denishelenko/esp8266-motor-control/docs/wiring-two-variants.png

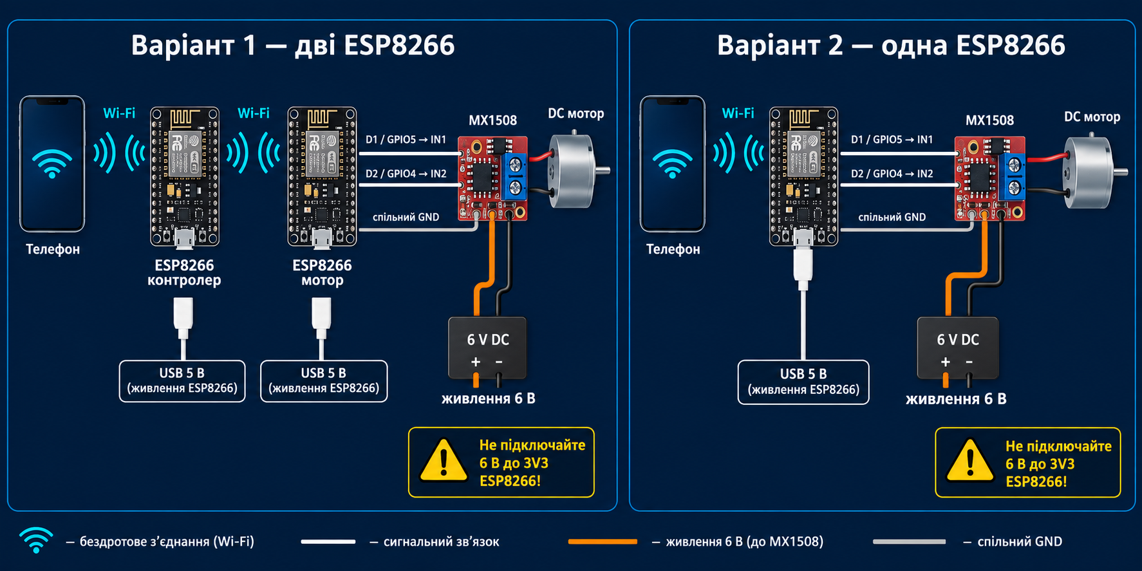
docs/wiring-two-variants.png
