denishelenko/esp8266-motor-control/12GAN20-20/Home dev internet/2_Carriages_WebSite/README.md

# Дві ESP32-S3 у мережі Motor-Control

Це окрема Home-версія двох кареток. Обидві плати ESP32-S3 N16R8 підключаються до **наявної** точки доступу `Motor-Control`, пароль `motor8266`. Мережу має створювати інший пристрій або роутер. Якщо точку доступу створювала стара ESP, вона повинна залишатися увімкненою. Жодна з цих двох кареток не роздає Wi-Fi.

**Обов'язково зафіксуйте на точці доступу 2,4 ГГц і канал 6.** Для ESP-NOW і Wi-Fi станції на одному радіомодулі потрібен спільний канал. Якщо точка доступу сама змінить канал, ці прошивки відхилять підключення до неї. Коли зовнішньої мережі немає, каретки залишаються на каналі 6 і можуть продовжувати обмін ESP-NOW, але сайт і OTA недоступні. Повторна спроба підключення робиться раз на 30 с тільки коли мотори стоять. Під час такої спроби команди руху тимчасово блокуються, оскільки один радіомодуль не гарантує безперервну передачу ESP-NOW під час сканування Wi-Fi.

| Роль | Arduino IDE | PlatformIO USB | PlatformIO OTA | Мережева адреса |
| --- | --- | --- | --- | --- |
| Головна каретка та сайт | `ESP32S3_Controller_Carriage_1/ESP32S3_Controller_Carriage_1.ino` | `dual_home_main_serial` | `dual_home_main_ota` | `http://motor.local/` |
| Друга каретка | `ESP32S3_Carriage_2/ESP32S3_Carriage_2.ino` | `dual_home_remote_serial` | `dual_home_remote_ota` | `motor-carriage-2.local` тільки для OTA |

Перший раз прошийте **кожну** плату через USB. В Arduino IDE виберіть 16 MB flash і **Partition Scheme: Custom**: у кожному скетчі вже є свій `partitions.csv` із двома OTA слотами. PlatformIO використовує таку саму таблицю розділів `default_16MB.csv`. Після цього підключіть комп'ютер до тієї самої мережі й прошивайте відповідним OTA профілем. OTA використовує порт 3232 і пароль `motor8266`. Якщо `.local` не знаходиться, використайте IP із Serial Monitor як `upload_port` у відповідному профілі.

Ніякого автоматичного визначення «застарілої прошивки» чи автоматичного завантаження немає. Оновлення починається лише після вашої команди **Upload**. Поки OTA не почався, ESP-NOW продовжує передавати команди та підтвердження. З початком OTA відповідна каретка зупиняє виходи й не виконує команди. Якщо оновлюється головна каретка, друга зупиниться за стоп-командою або власним тайм-аутом до 700 мс. Послідовне оновлення плат зменшує час, коли одна з них недоступна.

Для обох Home-кареток використовуйте [спільну схему підключення](../../README_TWO_CARRIAGES.md#піни-на-обох-каретках). Драйвер підключається до GPIO1 і GPIO2, сигнал на A1 TXS0108E до GPIO42, червоний LED до GPIO47, зелений до GPIO21. Фізичну перевірку зв'язку, руху та OTA на платах ще потрібно провести.
