denishelenko/esp8266-motor-control/12GAN20-20/2_Carriages_WebSite/ESP32S3_Carriage_2/README.md

# ESP32-S3 — друга каретка

Відкрийте `ESP32S3_Carriage_2.ino` в Arduino IDE.

Налаштування Arduino IDE такі самі, як для головної плати: `ESP32S3 Dev Module`, 16 MB Flash, OPI PSRAM, Upload Speed 115200.

Плата не створює власний сайт. Вона підключається до Wi‑Fi `Motor-Control` головної ESP32-S3 та приймає UDP-команди.
