denishelenko/esp8266-motor-control/12GAN20-20/Home dev internet/NodeMCU/README.md

# NodeMCU: однокареткова прошивка для домашнього Wi‑Fi

Це готова окрема копія скетчу для NodeMCU v3. Усі файли для Arduino IDE знаходяться в цій папці.

1. Відкрийте `NodeMCU.ino` саме з цієї папки.
2. В Arduino IDE виберіть `NodeMCU 1.0 (ESP-12E Module)`.
3. Виберіть правильний COM-порт і прошийте плату.
4. Відкрийте Serial Monitor на швидкості `115200`.

Назву мережі та пароль введіть безпосередньо у верхній частині `config.h`:

```cpp
constexpr char HOME_WIFI_SSID[] = "ENTER_WIFI_NAME";
constexpr char HOME_WIFI_PASSWORD[] = "ENTER_WIFI_PASSWORD";
```

У локальній копії для поточного тесту вже введено значення мережі. Перед публікацією замініть їх на заглушки.

Після запуску NodeMCU підключається тільки до домашнього Wi‑Fi, без створення мережі `Motor-Control`. У Serial Monitor з’явиться IP-адреса. Телефон потрібно підключити до тієї самої домашньої мережі, а сайт відкрити за цією IP-адресою.

Підключення каретки, двигунів, сервоприводу та RGB-індикатора не змінюється:

```text
D1 → IN1 L298N (PWM)
D2 → IN2 L298N (PWM)
D5 → сигнал сервоприводу через TXS0108E
D0 → R RGB (червоний)
D7 → G RGB (зелений)
```

Перемичку ENA на L298N залиште встановленою. Окремий ENA GPIO не використовується: PWM подається на активний IN1 або IN2.
