denishelenko/esp8266-motor-control/README_TWO_CARRIAGES.md

# Дві каретки: ESP32 + NodeMCU

Ця версія знаходиться на гілці `two-carriages` і не змінює `main`.

Детальна безпечна послідовність живлення та пайки: [`docs/WIRING_TWO_CARRIAGES.md`](docs/WIRING_TWO_CARRIAGES.md).

## Що прошивати

1. `ArduinoIDE/12_TwoCarriages_ESP32_Controller/` — ESP32-S3, перша каретка та сайт.
2. `ArduinoIDE/13_TwoCarriages_NodeMCU/` — NodeMCU v3, друга каретка.

Прошийте **обидві** плати з цієї версії: UDP-протокол версії 3 додає ідентифікатор сеансу та підтвердження команди. Старі прошивки з ним несумісні.

Телефон підключається лише до Wi-Fi ESP32:

- мережа: `Motor-Control`
- пароль: `motor8266`
- основна адреса сайту: `http://motor-control.local/`
- резервна адреса сайту: `http://192.168.4.1/`

Після підключення до Wi-Fi достатньо оновити сторінку за адресою `http://motor-control.local/`. Ім'я оголошує ESP32 через mDNS; NodeMCU адресу сайту не створює, а лише підключається до мережі ESP32.

NodeMCU автоматично підключається до цієї ж мережі і надсилає ESP32 свій статус. MAC-адреси та IP другої каретки вручну вводити не потрібно: ESP32 запам'ятовує адресу пакета статусу.

## Піни

### Перша каретка, ESP32-S3 + L298N

- GPIO4 → ENA, без перемички ENA.
- GPIO5 → IN1.
- GPIO6 → IN2.
- GPIO15 → жовтий сигнальний провід сервоприводу каретки 1.
- Спільний GND ESP32, L298N і джерела живлення обов'язковий.

### Друга каретка, NodeMCU v3 + L298N

- D1 / GPIO5 → ENA, без перемички ENA.
- D2 / GPIO4 → IN1.
- D5 / GPIO14 → IN2.
- D6 / GPIO12 → жовтий сигнальний провід сервоприводу каретки 2.
- GND NodeMCU → GND L298N.

Червоний провід кожного сервоприводу підключіть до окремого стабілізованого джерела 5–8.4 V, коричневий — до його GND. GND цього джерела, контролера і драйвера мають бути спільні. Не живіть сервоприводи від 3.3 V плати; вихід 5 V L298N також не варто використовувати без перевірки його струмової спроможності. Живлення двигуна — окремо відповідно до вашого L298N та двигуна.

## Як це працює

- ESP32 створює Wi-Fi AP і тримає сайт з WebSocket: усі телефони бачать спільний стан.
- ESP32 керує мотором каретки 1 напряму.
- ESP32 надсилає UDP-команду каретці 2 кожні 50 мс. NodeMCU одразу підтверджує номер прийнятої команди та передає фактично поданий PWM і стан сервоприводу; крім цього, статус надсилається кожні 300 мс.
- Сайт показує NodeMCU «онлайн» лише за свіжим статусом **і** новим підтвердженням команди (до 500 мс). Коли підтвердження зникає, друга каретка позначається «офлайн / немає сигналу», ланцюжок перекреслюється, її програма зупиняється; у режимі з'єднаного ланцюжка зупиняється й перша. Стара програма після відновлення зв'язку не запускається автоматично.
- Поки статус NodeMCU надходить, але підтвердження команди ще немає, ESP32 повторно надсилає **лише нульовий PWM і закритий сервопривід**, щоб безпечно відновити обмін. NodeMCU сам повторно підключається до Wi-Fi після розриву. Це підтвердження приймання команди, а не датчик фактичного положення каретки.
- Без нових команд NodeMCU починає зменшувати PWM після 700 мс і закриває сервопривід; двигун зупиняється плавно, не миттєво. ESP32 також плавно змінює PWM та проходить через нуль перед зміною напрямку.
- Якщо вимкнути синхронізацію кнопкою ланцюжка, команди й програми стосуються тільки вибраної каретки.
- «Маятник» вибраний за замовчуванням, але не запускається сам. «Старт» запускає вибраний режим, «Стоп» зупиняє тільки рух: увімкнений сервопривід продовжує свій цикл. Повторний «Старт» не скидає фазу сервоприводу. Натискання іншого режиму одразу запускає його. Пересування мішені скасовує режим і закриває сервопривід; повторний «Старт» запускає збережений вибраний режим.
- «Вимк.» у блоці «Керування сервоприводом» вимикає тільки його, не зупиняючи програму руху. Натискання 45° або 90° вмикає сервопривід і під час програми, і після «Стоп». При втраті зв’язку з NodeMCU сервопривід другої каретки вимикається з міркувань безпеки.
- Для кожної каретки окремо вибирається 45° або 90° фізичного відкриття сервоприводу. Під час режиму подається команда закриття на 2 с, потім команда відкриття на 1 с, і цикл повторюється. За результатами попереднього тесту команди сервоприводу подвоюються: 90° команди дають близько 45° фізично, 180° — близько 90°. Це не вимірювання положення: сервопривід не дає зворотного зв'язку, тому фактичний час досягнення кута залежить від механіки.
- Демо `web-interface-two-carriages-demo.html` не керує залізом і показує умовні 2 поділки сигналу для першої каретки та 4 для другої. Додайте `?node=offline` до адреси демо, щоб побачити вигляд втрати другої каретки. У робочому сайті рівень другої каретки береться з Wi-Fi RSSI NodeMCU, а «онлайн» вимагає підтвердження команд; для першої поки показано умовні 4 поділки, бо вона сама створює Wi-Fi. RSSI сам по собі не гарантує швидкості чи надійності зв'язку.

## Робоча ділянка й ручне вимірювання часу

У `ArduinoIDE/12_TwoCarriages_ESP32_Controller/config.h` задано `TRACK_LENGTH_M = 20` та `SAFE_MARGIN_M = 2`: від фізичних країв залишається по 2 м, робочий відрізок становить 16 м, а на сайті видно координати від −8 до +8 м. Фізичний центр потрібно встановити вручну та натиснути «Позначити поточне місце як центр». Це скидає **розрахункову** координату, а не визначає справжнє положення датчиком.

Окремий скетч `ArduinoIDE/14_Travel_Time_Test/` можна тимчасово прошити в кожну плату по черзі. Він не запускає двигун після ввімкнення. У Serial Monitor на 115200 baud введіть `P50` для 50%, поставте каретку на ліву робочу позначку (2 м від фізичного кінця), `R` для руху вправо та `S`, коли вона досягне правої робочої позначки. Запишіть час. Повторіть із `L` у зворотному напрямку. Час відлічується між введенням команд; затримка реакції людини впливає на точність. Не допускайте упору двигуна в механічний стопор: скетч **не має датчика кінця**, а 120-секундний тайм-аут лише обмежує тривалість руху.

Впишіть чотири виміряні значення (вправо/вліво для кожної каретки) у `TRAVEL_TIMES` у конфігурації ESP32. `TRAVEL_CALIBRATION_SPEED_PERCENT = 50` має відповідати швидкості тесту. До внесення даних код використовує явно позначену **тимчасову, не виміряну** оцінку `UNCALIBRATED_SPEED_AT_100_PERCENT_MPS = 0.80`. На інших швидкостях час оцінюється пропорційно PWM — це лише грубе припущення; для точності потрібно виміряти кілька швидкостей або додати енкодер.

Інший окремий скетч `ArduinoIDE/15_Servo_Travel_Test/` перевіряє тільки сервопривід на відповідному сигнальному піні. У Serial Monitor на 115200 введіть `0`, `90` або `180` — це **командні** градуси сервоприводу; за вашим тестом вони відповідають приблизно 0°, 45° і 90° фізично. Надішліть `D`, коли він фактично дійде до кута, і запишіть приблизний час. Через реакцію людини краще зняти рух на відео та порівняти кадри. Після вимірювання змініть два значення `SERVO_TRAVEL_90_MS` для кареток 1/2 у конфігурації ESP32: це впливає лише на анімацію стрілки на сайті, не прискорює фізичний сервопривід.

Після тестів знову прошийте в плати основні скетчі `12_...` і `13_...`: тестові скетчі сайту не створюють.

Координата на мішені поки що розрахункова. Перед механічним запуском перевірте напрямок, низьку швидкість та кнопку «Стоп». Програмне обмеження без енкодера й кінцевиків не гарантує захисту від фізичного виходу за край троса; проскальзування колеса також накопичує помилку координати. Після втрати зв'язку, прослизання або ручного пересування каретки повторно встановіть її у фізичний центр і обнуліть координату перед запуском програми.
