denishelenko/esp8266-motor-control/12GAN20-20/README_TWO_CARRIAGES.md

# Дві каретки: ESP32-S3 + ESP32-S3

Для вимірювання фактичного руху на 1, 2 і 5 секунд дивіться [фізичне калібрування](CALIBRATION_TWO_ESP32.md).

Комплект використовує дві **ESP32-S3 DevKitC-1 N16R8 з антенами 2,4 ГГц**. Перша плата створює Wi‑Fi для телефона, тримає сайт і керує своєю кареткою. Друга виконує команди й повертає статус через ESP-NOW.

**Живлення:** MP1584 є понижувачем, тому з батареї 7,8–8,4 V він може зробити 5 V, але не 12 V. Не подавайте 12 V на драйвер лише за написом «L9110S»: [даташит HTCSEMI](https://datasheet.lcsc.com/lcsc/2109081930_HTCSEMI-L9110S_C2895059.pdf) допускає до 12 V та близько 800 мА безперервно на канал, тоді як [даташит UMW](https://www.laskakit.cz/user/related_files/l9110s.pdf) задає робочі 2,2–6,5 V та абсолютну межу 8 V. Потрібно встановити виробника мікросхем на вашому модулі, перевірити їхню межу живлення, розпіновку, допустимий пусковий струм кожного мотора та сумісність входів з логікою ESP32-S3 3,3 V. Якщо це не підтверджено, використайте драйвер із документованою підтримкою 12 V, 3,3 V логіки й потрібного струму.

## Що прошивати

1. [ESP32S3_Controller_Carriage_1.ino](<Arduino IDE/2_Carriages_WebSite/ESP32S3_Controller_Carriage_1/ESP32S3_Controller_Carriage_1.ino>) або профіль `dual_esp32s3_controller`.
2. [ESP32S3_Carriage_2.ino](<Arduino IDE/2_Carriages_WebSite/ESP32S3_Carriage_2/ESP32S3_Carriage_2.ino>) або профіль `dual_esp32s3_remote`.

Прошийте **обидві** плати з цієї пари. У PlatformIO відкрийте [папку проєкту](PlatformIO).

В Arduino IDE виберіть `ESP32S3 Dev Module`, Flash Size `16MB`, PSRAM `OPI PSRAM` і Upload Speed `115200`. Перевірені версії пакета `esp32 by Espressif Systems` 3.3.12, `ArduinoJson` 7.4.3 і `WebSockets` 2.7.2. Другий скетч використовує бібліотеки з пакета плат. Serial Monitor працює на `115200` бод.

Телефон підключається лише до Wi-Fi ESP32:

- мережа: `Motor-Control`
- пароль: `motor8266`
- основна адреса сайту: `http://motor-control.local/`
- резервна адреса сайту: `http://192.168.4.1/`

Після підключення до Wi-Fi достатньо оновити сторінку за адресою `http://motor-control.local/`. Ім'я оголошує головна ESP32-S3 через mDNS; друга ESP32-S3 сайту не створює, а обмінюється командами через ESP-NOW на тому самому радіоканалі.

Друга ESP32-S3 спілкується з головною через ESP-NOW; у звичайній версії вона не підключається як Wi-Fi-клієнт до мережі головної плати. Обидві використовують канал `WIFI_CHANNEL = 6` і той самий `ESPNOW_GROUP_ID` у своїх `config.h`. Плати запам'ятовують MAC-адреси автоматично. Якщо поруч працюватимуть кілька комплектів, задайте кожній парі свій спільний `ESPNOW_GROUP_ID`. Ідентифікатор розділяє комплекти. Кадри ESP-NOW передаються без шифрування.

## Піни на обох каретках

| Контакт ESP32-S3 | Куди підключати |
| --- | --- |
| `1` | A1A і B1A драйвера (угорі правої колодки) |
| `2` | A1B і B1B драйвера (угорі правої колодки) |
| `42` | A1 TXS0108E. З B1 TXS0108E на жовтий провід серво. GPIO42 має бути вільним від зовнішнього JTAG |
| `47` | Червоний LED через резистор (унизу правої колодки) |
| `21` | Зелений LED через окремий резистор (унизу правої колодки) |
| `3V3` | VA TXS0108E. Перемичка VA–OE |
| `5V` | 5 В від понижувача. З тієї ж точки 5 В на VB TXS0108E |
| `GND` | Спільний мінус джерел, драйвера, TXS0108E, серво та RGB |

Якщо плата вже спаяна за попередньою схемою, від'єднайте живлення моторів перед заміною проводів і прошивки. Поверніть живлення після того, як розпайка й прошивка відповідатимуть одне одному. Для драйвера, у якого LOW на обох входах означає стоп, два окремі резистори по 10 кОм від IN1 та IN2 до GND утримають входи в LOW під час скидання ESP32, якщо драйвер не має власної підтяжки до землі.

Мотор 1 підключається до виходів моста A, мотор 2 до виходів моста B. Розгалужуються лише входи, щоб мости отримували однакові PWM і напрямок. У стані стоп обидва входи на LOW. Для 12 В використовуйте драйвер, який підтримує цю напругу, приймає логіку 3,3 В і витримує пусковий струм моторів. Якщо «Вліво» фізично рухає каретку вправо, змініть `MOTOR_DIRECTION_REVERSED` на `true` у `config.h` саме цієї плати.

Червоний провід серво отримує 5 В напряму від понижувача, коричневий підключається до GND. Драйвер отримує свою пару живлення напряму від джерела моторної напруги. Об'єднайте мінуси живлення в спільній точці. Перед підключенням плати заміряйте обидва виходи та перевірте полярність.

## Як це працює

- ESP32 створює Wi-Fi AP і тримає сайт з WebSocket: усі телефони бачать спільний стан.
- ESP32 керує мотором каретки 1 напряму.
- Головна ESP32-S3 надсилає команду ESP-NOW каретці 2 кожні 50 мс після її виявлення. Друга плата підтверджує номер прийнятої команди та повертає PWM і заданий кут серво. Вона також надсилає статус або повідомлення пошуку кожні 300 мс.
- Сайт показує другу ESP32-S3 «онлайн» лише за свіжим статусом **і** новим підтвердженням команди (до 500 мс). Коли підтвердження зникає, друга каретка позначається «офлайн / немає сигналу», ланцюжок перекреслюється, її програма зупиняється; у режимі з'єднаного ланцюжка зупиняється й перша. Стара програма після відновлення зв'язку не запускається автоматично.
- Поки немає свіжого підтвердження, головна плата надсилає лише **нульовий PWM і команду закриття серво**. Віддалена каретка відновлює пошук після розриву зв'язку.
- Через 700 мс без нової команди друга ESP32-S3 встановлює нульовий PWM і подає команду закриття серво. Під час зміни напряму обидві плати проходять через нуль. Після відпускання кнопки ручного руху або через 650 мс без її оновлення PWM скидається до нуля. Фізична каретка може ще рухатися за інерцією.
- Якщо вимкнути синхронізацію кнопкою ланцюжка, команди й програми стосуються тільки вибраної каретки.
- «Маятник» вибраний за замовчуванням, але не запускається сам. «Старт» запускає вибраний режим, «Стоп» зупиняє тільки рух: увімкнений сервопривід продовжує свій цикл. Повторний «Старт» не скидає фазу сервоприводу. Натискання іншого режиму одразу запускає його. Пересування мішені скасовує режим і закриває сервопривід; повторний «Старт» запускає збережений вибраний режим.
- «Вимк.» у блоці «Керування сервоприводом» вимикає тільки його, не зупиняючи програму руху. Натискання 45° або 90° вмикає сервопривід і під час програми, і після «Стоп». При втраті зв'язку з другою ESP32-S3 сервопривід другої каретки вимикається з міркувань безпеки.
- Для кожної каретки окремо вибирається 45° або 90° фізичного відкриття сервоприводу. Цикл подає команду закриття на 2,5 с і команду відкриття на 2,5 с. За результатами попереднього тесту 90° команди дають близько 45° фізично, 180° дають близько 90°. Затримки рахуються від моменту команди, оскільки сервопривід не повертає фактичний кут.
- RGB світиться зеленим при нульовому PWM і блимає червоним, коли на двигун подається PWM.
- Демо `web-interface-two-carriages-demo.html` імітує рівень сигналу. У робочому сайті рівень другої каретки береться з RSSI отриманих кадрів ESP-NOW, а «онлайн» вимагає свіжого підтвердження. Для першої показано умовні 4 поділки, коли сайт доступний.

## Робоча ділянка й ручне вимірювання часу

У [конфігурації головної плати](<Arduino IDE/2_Carriages_WebSite/ESP32S3_Controller_Carriage_1/config.h>) задано `TRACK_LENGTH_M = 20` та `SAFE_MARGIN_M = 2`. Від країв залишається по 2 м, робочий відрізок становить 16 м, а на сайті видно координати від −8 до +8 м. Встановіть каретку у фізичний центр і натисніть «Позначити поточне місце як центр», щоб скинути розрахункову координату.

Тест часу проходження тепер виконується основною прошивкою після ручного вимірювання; окремий тестовий скетч у цій структурі не зберігається.

Впишіть чотири виміряні значення (вправо/вліво для кожної каретки) у `TRAVEL_TIMES` у конфігурації ESP32. `TRAVEL_CALIBRATION_SPEED_PERCENT = 50` має відповідати швидкості тесту. До внесення даних код використовує явно позначену **тимчасову, не виміряну** оцінку `UNCALIBRATED_SPEED_AT_100_PERCENT_MPS = 0.80`. На інших швидкостях час оцінюється пропорційно PWM — це лише грубе припущення; для точності потрібно виміряти кілька швидкостей або додати енкодер.

Тест сервопривода виконується кнопками `45°`, `90°` і `Вимк.` на сайті; окремий тестовий скетч у цій структурі не зберігається.

Після тестів залишайте в платах основні скетчі з папок `ESP32S3_Controller_Carriage_1` і `ESP32S3_Carriage_2`; окремі тестові скетчі в цій структурі не створюються.

Координата на мішені поки що розрахункова. Перед механічним запуском перевірте напрямок, низьку швидкість та кнопку «Стоп». Програмне обмеження без енкодера й кінцевиків не гарантує захисту від фізичного виходу за край троса; проскальзування колеса також накопичує помилку координати. Після втрати зв'язку, прослизання або ручного пересування каретки повторно встановіть її у фізичний центр і обнуліть координату перед запуском програми.
