denishelenko/esp8266-motor-control/12GAN20-20/ESP32S3_AUDIT.md

# Перевірка прошивок ESP32-S3 N16R8

## Що оновлено

- PlatformIO Espressif32: 8.0.0 з Arduino-ESP32 3.3.12 та ESP-IDF 5.5.5 (було pioarduino 55.03.33 з Arduino-ESP32 3.3.3).
- WebSockets: 2.7.2 (було 2.3.6). ArduinoJson 7.4.3 та PlatformIO ESP8266 4.2.1 залишено, бо це актуальні стабільні версії.
- Обидва ESP32-S3 профілі для COM використовують 115200 бод. Плата N16R8 означає **16 МБ flash і 8 МБ OPI PSRAM**, тому конфігурація плати не змінена на 32 МБ.
- Керування фізичними виходами винесено до `controller_hardware.h` та `remote_hardware.h`; стан, оцінку руху й алгоритми першої каретки — до `controller_state.h`, `controller_estimator.h`, `controller_motion.h`. Такий самий поділ застосовано до стандартної версії з власним Wi-Fi і до Home-версії з зовнішнім Wi-Fi та OTA.
- WebSocket-стан першої каретки тепер передає `estimatedTravelSeconds` для кожної каретки. Це оцінка часу до поточної цілі; її формула живе окремо від алгоритмів руху, тому згодом її можна замінити даними енкодера або датчика Холла.

## Що не мінялось у поведінці

- Виходи обох ESP32-S3: `1` → IN1 обох мостів L9110S, `2` → IN2 обох мостів, `42` → A1 TXS0108E для сервопривода, `47` → червоний LED, `21` → зелений LED.
- Головна каретка розміщує сайт; друга отримує команди через ESP-NOW і відправляє статус. Збережено контроль підтверджень, тайм-аути та зупинку мотора при втраті зв'язку.
- Трос 20 м, запас 2 м з кожного краю, робоча зона 16 м: від −8 до +8 м. `TRAVEL_TIMES` у `config.h` досі нульові. До реального вимірювання програма користується тимчасовою швидкістю; положення на сайті **не є показом датчика**.
- Home-версія потребує окремої зовнішньої точки доступу `Motor-Control` на 2,4 ГГц, канал 6. Звичайна версія створює власну точку доступу. Їх не слід прошивати як взаємозамінні ролі.

## Перевірки та межі

- Порівняно 40 перенесених функцій з вихідним кодом: тіла функцій не змінені. Таким чином винесення у файли не змінює їхню логіку.
- PlatformIO Core 6.1.18: після оновлення залежностей успішно зібрано 7 профілів: `dual_esp32s3_controller`, `dual_esp32s3_remote`, `dual_home_main_serial`, `dual_home_remote_serial`, `single_esp32s3`, `single_nodemcu`, `single_d1_mini_pro`. Після остаточного форматування чотири двокареткові профілі зібрано повторно, усі успішно. Профілі `_ota` використовують ті самі вихідні файли, що й відповідні `_serial`; саме завантаження OTA без пристроїв не перевірялося.
- `git diff --check` пройшов без помилок. Arduino IDE окремо не запускали; PlatformIO компілює ті самі Arduino-скетчі та локальні заголовки.
- Фізичні ESP32-S3, драйвери, сервоприводи та Wi-Fi-канал у цій перевірці не тестувалися. Потрібно окремо заміряти час проходження 16 м для кожної каретки та напрямку, перевірити напрямок IN1/IN2 і тривалість фактичного повороту сервопривода.
- Різні виробники L9110S задають різні межі VCC: зокрема HTCSEMI допускає 12 V, UMW — лише 6,5 V у робочому режимі. До подачі 12 V перевірте точне маркування мікросхем вашого модуля, 3,3 V рівень входів і пусковий струм моторів; програмна перевірка цього не замінює. Джерела наведено у `README_TWO_CARRIAGES.md`.
- `Connecting... No serial data received` виникає **до запису й запуску скетча**. Оновлення коду не може змусити плату відповісти завантажувачу. Для нової або раніше прошитої справної плати процедура COM однакова: один підключений ESP32-S3, правильний COM, справний кабель UART, режим BOOT за потреби. Якщо Windows не розпізнає нативний USB і UART COM не отримує відповіді навіть на окремій платі, перевіряйте апаратну частину; прошивка цього не виправить.

## Файли та профілі

Відкрийте `PlatformIO` як папку проєкту. `dual_esp32s3_controller` прошиває першу каретку з сайтом, `dual_esp32s3_remote` — другу. `dual_home_main_serial` та `dual_home_remote_serial` — окремі прошивки для зовнішньої Wi-Fi мережі; їхні `_ota` профілі призначені лише для оновлення вже прошитих плат через мережу. Файли `src/*.cpp` обирають відповідний скетч, а код редагується в папках `Arduino IDE` або `Home dev internet`.
