denishelenko/esp8266-motor-control/12GAN20-20/WIRING_TEXT_ESP32S3_L9110S.md

# Текстова інструкція пайки: ESP32-S3 + L9110S + TXS0108E

У цьому проєкті використовується **ESP32-S3**, а не STM32. Обидві каретки мають однакову плату ESP32-S3 DevKitC-1-N16R8.

## 0. Критичне уточнення перед пайкою

MP1584 — це понижувач. Він може знизити 7,8–8,4 V до 5 V, але не може підняти напругу до 12 V.

Напис «L9110S» не визначає допустиму напругу конкретного модуля. [HTCSEMI L9110S](https://datasheet.lcsc.com/lcsc/2109081930_HTCSEMI-L9110S_C2895059.pdf) допускає до 12 V, а [UMW L9110S](https://www.laskakit.cz/user/related_files/l9110s.pdf) працює до 6,5 V (абсолютна межа 8 V). Перед подачею 12 V ідентифікуйте мікросхеми, перевірте паспорт модуля, пусковий струм кожного мотора та чи входи гарантовано сприймають 3,3 V від ESP32. Якщо ці параметри не підтверджено, виберіть H-bridge з документованою підтримкою 12 V, 3,3 V логіки та потрібного струму.

Нижче описана розпайка саме логіки L9110S. Якщо залишається L9110S, його моторне живлення має бути не вище дозволеного паспортом конкретної плати.

## 1. Підготовка живлення

Перед підключенням ESP32, драйвера, сервопривода і моторів від'єднайте батарею.

1. Припаяйте плюс батареї до `IN+` підвищувача.
2. Припаяйте мінус батареї до `IN-` підвищувача.
3. Увімкніть батарею без навантаження і мультиметром налаштуйте вихід підвищувача на потрібну напругу моторного драйвера.
4. Вимкніть батарею.
5. Підключіть MP1584 до входу живлення батареї: `IN+` MP1584 → плюс батареї, `IN-` MP1584 → мінус батареї.
6. Увімкніть батарею і мультиметром налаштуйте вихід MP1584 рівно на `5,0 V`.
7. Після налаштування знову вимкніть батарею.

Для ESP32-S3 та сервопривода використовуйте окремі вихідні пари дротів від 5-вольтової шини MP1584:

```text
MP1584 OUT+ 5 V, пара 1 → ESP32-S3 пін 5V
MP1584 OUT-     , пара 1 → ESP32-S3 пін GND

MP1584 OUT+ 5 V, пара 2 → червоний провід сервопривода
MP1584 OUT-     , пара 2 → коричневий провід сервопривода
```

Сервопривід має короткі струмові піки. Якщо ESP32 перезавантажується під час руху серво, поставте для сервопривода окремий MP1584/понижувач 5 V, але мінуси все одно об'єднайте.

## 2. Спільна земля

Усі мінуси повинні бути з'єднані в одну спільну землю:

```text
мінус батареї
мінус підвищувача
мінус MP1584
GND ESP32-S3
GND L9110S
GND TXS0108E
коричневий провід сервопривода
спільний мінус RGB
```

Не підключайте 12 V або 5 V до будь-якого GPIO ESP32-S3.

## 3. Головна ESP32-S3: каретка 1, сайт і мотор

Головна плата створює Wi‑Fi `Motor-Control`, запускає сайт і одночасно керує своєю кареткою.

### L9110S каретки 1

```text
ESP32-S3 GPIO6 → IA L9110S
ESP32-S3 GPIO7 → IB L9110S
ESP32-S3 GND   → GND L9110S
живлення двигуна дозволеної напруги → VCC L9110S
```

Виходи двигуна:

```text
OA L9110S → перший провід двигуна
OB L9110S → другий провід двигуна
```

Якщо два мотори механічно працюють як одна каретка і підключаються паралельно:

```text
OA → перший провід двигуна 1 + перший провід двигуна 2
OB → другий провід двигуна 1 + другий провід двигуна 2
```

Так робіть лише після перевірки струму драйвера. Для типового L9110S два мотори по приблизно 0,28 A кожен уже перевищують можливості одного каналу.

## 4. Друга ESP32-S3: каретка 2

На другій платі використовується така сама розпайка:

```text
ESP32-S3 GPIO6 → IA L9110S
ESP32-S3 GPIO7 → IB L9110S
ESP32-S3 GND   → GND L9110S
живлення двигуна дозволеної напруги → VCC L9110S
```

Друга плата не створює сайт. Вона підключається до Wi‑Fi головної ESP32-S3 та приймає UDP-команди.

## 5. Плата логічних рівнів TXS0108E

Використовується один канал TXS0108E для сигналу сервопривода.

```text
ESP32-S3 3V3 → VA TXS0108E
MP1584 5 V   → VB TXS0108E
GND ESP32-S3 → GND TXS0108E
ESP32-S3 GPIO15 → A1 TXS0108E
B1 TXS0108E → жовтий сигнальний провід сервопривода
```

`OE` потрібно тримати у високому рівні для роботи перетворювача:

```text
VA 3,3 V → OE TXS0108E
```

Якщо на синій платі є перемичка `OE`, встановіть її саме у положення, яке з'єднує `OE` з `VA/3,3 V`. Не подавайте на `OE` 12 V.

Схема однакова для сервопривода каретки 1 і каретки 2: кожна ESP32-S3 має свій TXS0108E та свій сервопривід.

## 6. Сервопривід

```text
жовтий провід → B1 TXS0108E
червоний провід → окремий вихід 5 V MP1584
коричневий провід → GND MP1584 / спільна земля
```

Сервопривід не живиться від GPIO та не живиться від 3,3 V.

## 7. RGB-індикатор

Для RGB зі спільним мінусом:

```text
ESP32-S3 GPIO16 → R через власний резистор 250–1000 Ом
ESP32-S3 GPIO17 → G через власний резистор 250–1000 Ом
спільний мінус RGB → GND
B RGB → не підключати
```

Логіка роботи:

```text
каретка стоїть → зелений світить постійно
каретка рухається → зелений вимкнений, червоний блимає
```

Для майбутнього 12-вольтового світлодіода GPIO напряму не підходить — потрібен MOSFET або транзисторний ключ із резистором на затворі/базі.

## 8. Розташування компонентів

Рекомендоване розташування на кожній каретці:

```text
ВЕРХ:
  L9110S і силові дроти моторів
  підвищувач або моторний DC-DC (тільки з перевіреною напругою драйвера)

ЦЕНТР:
  ESP32-S3 DevKitC-1-N16R8

НИЖЧЕ ESP32:
  синя плата TXS0108E
  MP1584 5 V і розгалуження 5 V на ESP32 та серво

НИЗ:
  сервопривід і його три дроти
```

Силові дроти моторів прокладайте окремо від сигнальних дротів GPIO15/IA/IB. Мінус живлення з'єднайте товстим спільним проводом біля драйвера.

## 9. Перевірка перед першим запуском

1. Без ESP32 і моторів перевірте мультиметром вихід MP1584: `5,0 V`.
2. Перевірте полярність усіх `+` і `GND`.
3. Підключіть тільки ESP32-S3 через 5V/GND і прошийте головну плату.
4. Перевірте Wi‑Fi `Motor-Control` та сайт `http://motor-control.local/` або `http://192.168.4.1/`.
5. Підключіть TXS0108E і перевірте VA=3,3 V, VB=5 V, OE=3,3 V.
6. Підключіть сервопривід без моторів і перевірте 45°/90°.
7. Підключіть L9110S без моторів і перевірте IA/IB мультиметром/логічним аналізатором.
8. Підключіть спочатку один мотор на короткий тест.
9. Другий мотор підключайте лише після перевірки струму та нагріву драйвера.

Під час прошивання USB-кабелем не підключайте одночасно несумісні джерела 5 V. Після завершення тесту від'єднайте USB або зовнішнє 5 V відповідно до конкретної схеми плати.

## 10. Логіка прошивки

- головна ESP32-S3: Wi‑Fi AP, сайт, WebSocket, мотор 1, серво 1, RGB 1;
- друга ESP32-S3: Wi‑Fi STA, UDP-команди, мотор 2, серво 2, RGB 2;
- команди другої каретки надсилаються приблизно кожні 50 мс;
- друга плата підтверджує прийняту послідовність команд;
- при втраті зв'язку друга каретка зупиняє мотор і вимикає сервопривід;
- серво утримує відкриту та закриту позиції по 2,5 секунди;
- трос 20 м мінус запас по 2 м дає робочу ділянку 16 м, координати на сайті — від −8 до +8 м;
- координата без енкодера є розрахунковою, тому після прослизання потрібно знову виставити фізичний центр.
