denishelenko/esp8266-motor-control/docs/WIRING_TWO_CARRIAGES.md

# Пайка та живлення: дві каретки

Ця інструкція відповідає двом основним прошивкам:

1. `ArduinoIDE/12_TwoCarriages_ESP32_Controller/` — ESP32-S3, каретка 1 і сайт.
2. `ArduinoIDE/13_TwoCarriages_NodeMCU/` — NodeMCU v3, каретка 2.

## Увага: спочатку підготуйте живлення

1. Від'єднайте **всі** ESP, L298N, сервоприводи й двигуни від батареї.
2. Підключіть батарею тільки до входу підвищувача 12 V.
3. Мультиметром налаштуйте його вихід рівно на **12.0 V**. Лише після цього вимкніть батарею та починайте пайку інших модулів.
4. Від 12 V зробіть дві гілки: на L298N і на **окремий понижувач 12 V → стабільні 5.0 V**.

Не використовуйте вихід `5V` L298N для живлення сервоприводу або ESP. На модулях L298N цей вихід залежить від перемички та вбудованого стабілізатора; при 12 V він може перегріватися, а короткі піки струму сервоприводу здатні перезапустити ESP.

Понижувач 5 V має бути розрахований на піковий струм сервоприводу. Орієнтир для однієї каретки — **не менше 3 A** на 5 V; якщо обидва сервоприводи живляться одним модулем, його струм має покривати суму їхніх піків із запасом.

Усі «мінуси» обов'язково з'єднані разом: батарея / 12 V, L298N, 5 V понижувач, ESP, TXS0108E і сервопривід.

## Однакова силова схема для кожної каретки

```text
батарея → підвищувач, налаштований на 12.0 V
                         ├→ L298N: +12V і GND
                         └→ понижувач 12V→5V: +5V і GND
                                                   ├→ ESP (5V/VIN + GND)
                                                   ├→ сервопривід (червоний +5V, коричневий GND)
                                                   └→ TXS0108E: VB +5V, GND
```

Використовуйте провід достатнього перерізу для двигунів і живлення сервоприводу. Сигнальні дроти ESP не повинні нести струм двигуна або сервоприводу.

## L298N та два двигуни на одній каретці

Кожна каретка використовує **канал A** свого L298N. Два однакові двигуни підключаються паралельно до одного моста:

```text
L298N OUT1 → «+» двигуна 1 і «+» двигуна 2
L298N OUT2 → «−» двигуна 1 і «−» двигуна 2
```

Якщо двигуни мають крутитися в один бік, їхня полярність має бути однакова. Якщо один крутиться навпаки — поміняйте місцями **лише його** два моторні дроти. Перед постійним використанням перевірте сумарний струм двох двигунів: він не повинен перевищувати реальні можливості вашого L298N з радіатором.

На L298N:

- `+12V` → вихід 12 V підвищувача.
- `GND` → спільний мінус.
- `5V` → +5 V з понижувача **як вхід живлення логіки**.
- `OUT1` / `OUT2` → два двигуни, як описано вище.
- Перемички `ENA` і `5V-EN` **зняти**.
- `ENA`, `IN1`, `IN2` → три керувальні дроти з ESP.

Саме три дроти потрібні для програмного керування: `ENA` задає PWM-швидкість, а `IN1` і `IN2` задають напрямок або стоп. Перемичка ENA не повинна бути встановлена, інакше швидкість PWM не керуватиметься з прошивки.

Не плутайте перемички: `ENA` вмикає канал двигуна на повну швидкість, а `5V-EN` вмикає внутрішній стабілізатор модуля. У цій схемі внутрішній стабілізатор L298N не використовується: `5V-EN` знята, а стабільні 5 V з окремого понижувача подаються на клему `5V` L298N, ESP, TXS0108E і сервопривід. Не подавайте 5 V одночасно на клему `5V`, якщо на вашій платі залишено `5V-EN`.

## Каретка 1: ESP32-S3 + L298N + сервопривід

### L298N

- `GPIO4` → `ENA` L298N.
- `GPIO5` → `IN1` L298N.
- `GPIO6` → `IN2` L298N.
- `GND` ESP32 → спільний `GND`.
- `5V` плати ESP32-S3 → +5 V з **окремого понижувача**.

### TXS0108E і сервопривід

- `GPIO15` ESP32 → `A1` TXS0108E.
- `3V3` ESP32 → `VA` TXS0108E.
- `OE` TXS0108E → той самий `3V3` / `VA`.
- +5 V понижувача → `VB` TXS0108E.
- Спільний мінус → `GND` TXS0108E.
- `B1` TXS0108E → жовтий сигнальний провід сервоприводу.
- Червоний сервоприводу → +5 V понижувача.
- Коричневий сервоприводу → спільний GND.

## Каретка 2: NodeMCU v3 + L298N + сервопривід

### L298N

- `D1` / `GPIO5` → `ENA` L298N.
- `D2` / `GPIO4` → `IN1` L298N.
- `D5` / `GPIO14` → `IN2` L298N.
- `GND` NodeMCU → спільний `GND`.
- `VIN` NodeMCU → +5 V з **окремого понижувача**.

### TXS0108E і сервопривід

- `D6` / `GPIO12` NodeMCU → `A1` TXS0108E.
- `3V3` NodeMCU → `VA` TXS0108E.
- `OE` TXS0108E → той самий `3V3` / `VA`.
- +5 V понижувача → `VB` TXS0108E.
- Спільний мінус → `GND` TXS0108E.
- `B1` TXS0108E → жовтий сигнальний провід сервоприводу.
- Червоний сервоприводу → +5 V понижувача.
- Коричневий сервоприводу → спільний GND.

## TXS0108E: що не можна переплутати

- `VA` — низьковольтна сторона: **3.3 V** від ESP.
- `VB` — високовольтна сторона: **5 V** від понижувача.
- `OE` — увімкнення перетворювача. Його підключають до **3.3 V / VA**, не до 5 V.
- `A1` — 3.3-вольтовий сигнал від ESP.
- `B1` — 5-вольтовий сигнал до жовтого дроту сервоприводу.

TXS0108E не живить сервопривід і не є понижувачем/підвищувачем напруги. Через нього проходить лише логічний PWM-сигнал.

## LED — тільки за потреби

У поточних двох прошивках окремий зовнішній LED не задіяний. Якщо додаватимете індикатор пізніше, GPIO ESP має 3.3 V логіку:

- звичайний світлодіод: GPIO → резистор 330–1000 Ом → анод LED, катод → GND;
- LED-модуль, що живиться від 3.3 V: його сигнальний вхід → GPIO, GND → спільний GND;
- 5-вольтовий LED-модуль або стрічку не підключайте напряму до GPIO: потрібен транзисторний/MOSFET-ключ.

## Порядок першого ввімкнення

1. Перевірте мультиметром 12 V та 5.0 V без навантаження.
2. Підключіть лише ESP до 5 V понижувача та прошийте обидві плати. Переконайтеся, що ESP32 створює Wi-Fi `Motor-Control`, а NodeMCU підключається до нього.
3. Знеструмте систему, підключіть `ENA/IN1/IN2` та TXS0108E, але поки без двигуна і сервоприводу. Увімкніть: самовільного руху бути не повинно.
4. Підключіть сервопривід і перевірте 45° / 90° без навантаження на механіку.
5. Підніміть колеса каретки над тросом або зніміть навантаження, підключіть двигуни. На малій швидкості перевірте напрямки та кнопку «Стоп».
6. Лише після цього запускайте каретку на тросі та окремо виконайте вимірювання часу руху 16 м зі скетчем `14_Travel_Time_Test`.

Перед будь-якою перепайкою або встановленням/зняттям перемичок повністю вимикайте батарею.
