denishelenko/esp8266-motor-control/ArduinoIDE/03_OneESP/config.h

#pragma once

#include <Arduino.h>

// Wi-Fi network created by the controller ESP8266.
// Change these two values before using the system in a public place.
constexpr char WIFI_SSID[] = "Motor-Control";
constexpr char WIFI_PASSWORD[] = "motor8266";  // 8 characters minimum
constexpr uint8_t WIFI_CHANNEL = 6;

constexpr uint16_t HTTP_PORT = 80;
constexpr uint16_t WEBSOCKET_PORT = 81;
constexpr char CONTROLLER_IP[] = "192.168.4.1";

// Wemos D1 Mini Pro (ESP8266) -> L298N channel A with two DC motors
// connected in parallel. D3 (GPIO0) and D4 (GPIO2) are boot pins: neither
// connected module may pull them LOW while the Wemos is starting.
// Remove the ENA jumper before connecting MOTOR_ENA_PIN.
constexpr uint8_t MOTOR_ENA_PIN = 5;  // GPIO5 / D1  -> L298N ENA (PWM)
constexpr uint8_t MOTOR_IN1_PIN = 4;  // GPIO4 / D2  -> L298N IN1
constexpr uint8_t MOTOR_IN2_PIN = 0;  // GPIO0 / D3  -> L298N IN2

// SERVOMY SDS2601-26G signal. Power the servo from a separate 5-8.4 V supply
// and connect the servo supply ground to ESP8266 GND.
constexpr uint8_t SERVO_SIGNAL_PIN = 2;  // GPIO2 / D4 -> yellow signal wire
constexpr uint8_t SERVO_CLOSED_ANGLE = 0;
constexpr uint8_t SERVO_DEFAULT_OPEN_ANGLE = 45;
constexpr uint16_t SERVO_MIN_PULSE_US = 520;
constexpr uint16_t SERVO_MAX_PULSE_US = 2520;
constexpr uint16_t SERVO_FREQUENCY_HZ = 333;
// Smooth motion: one commanded degree per step. After reaching an endpoint,
// the servo stays open for 1 s and closed for 0.5 s.
constexpr uint8_t SERVO_STEP_DEGREES = 1;
constexpr uint32_t SERVO_STEP_INTERVAL_MS = 20;
constexpr uint32_t SERVO_OPEN_HOLD_MS = 1000;
constexpr uint32_t SERVO_CLOSED_HOLD_MS = 500;

constexpr uint16_t PWM_MAX = 1023;
constexpr uint16_t PWM_FREQUENCY_HZ = 1000;

constexpr uint8_t SPEED_MIN_PERCENT = 1;
constexpr uint8_t SPEED_MAX_PERCENT = 100;
constexpr uint8_t SPEED_DEFAULT_PERCENT = 50;

// Virtual track. Four metres total means centre 0 and physical ends -2..+2 m.
// SAFE_MARGIN_M keeps software targets away from the physical ends.
constexpr float TRACK_LENGTH_M = 4.0f;
constexpr float SAFE_MARGIN_M = 0.20f;
constexpr float POSITION_TOLERANCE_M = 0.015f;

// Replace these example values after measuring your actual mechanism.
// Each row is: PWM percent, speed to the right, speed to the left (metres/sec).
struct CalibrationPoint {
  uint8_t pwmPercent;
  float rightMetersPerSecond;
  float leftMetersPerSecond;
};

constexpr CalibrationPoint SPEED_CALIBRATION[] = {
  {0, 0.00f, 0.00f},
  {20, 0.12f, 0.12f},
  {40, 0.28f, 0.28f},
  {60, 0.47f, 0.47f},
  {80, 0.65f, 0.65f},
  {100, 0.88f, 0.88f},
};
constexpr size_t SPEED_CALIBRATION_COUNT = sizeof(SPEED_CALIBRATION) / sizeof(SPEED_CALIBRATION[0]);

// Safety timings.
constexpr uint32_t JOG_DEADMAN_TIMEOUT_MS = 650;
constexpr uint32_t MOTOR_PACKET_TIMEOUT_MS = 1000;
constexpr uint32_t MOTOR_LINK_TIMEOUT_MS = 500;
constexpr uint32_t ESPNOW_COMMAND_INTERVAL_MS = 20;
constexpr uint32_t MOTOR_STATUS_INTERVAL_MS = 100;
constexpr uint32_t ESPNOW_PAIR_INTERVAL_MS = 250;
constexpr uint32_t UI_BROADCAST_INTERVAL_MS = 50;

// Signed PWM is moved toward the target every 10 ms. This softens starts and
// forces direction changes to cross zero first.
constexpr uint32_t RAMP_INTERVAL_MS = 10;
constexpr int16_t RAMP_STEP = 24;
