denishelenko/esp8266-motor-control/12GAN20-20/Arduino IDE/2_Carriages_WebSite/ESP32S3_Carriage_2/remote_hardware.h

#pragma once

// ESP32-S3 motor, servo and indicator outputs.

void writeServoAngle(uint8_t physicalAngle) {
  physicalAngle = constrain(physicalAngle, SERVO_CLOSED_ANGLE, SERVO_PHYSICAL_MAX_ANGLE);
  const uint8_t commandAngle = physicalAngle * SERVO_COMMAND_PER_PHYSICAL_DEGREE;
  const uint32_t pulseUs = map(commandAngle, 0, 180, SERVO_MIN_PULSE_US, SERVO_MAX_PULSE_US);
  const uint32_t duty = (uint64_t(pulseUs) * SERVO_FREQUENCY_HZ * 16384ULL + 500000ULL) / 1000000ULL;
  ledcWrite(SERVO_SIGNAL_PIN, duty);
}

void writeLights(bool redEnabled) {
  if (redOutputOn != redEnabled) {
    redOutputOn = redEnabled;
    digitalWrite(LIGHT_RED_PIN, redEnabled ? HIGH : LOW);
  }
}

void updateLights(uint32_t now) {
  if (appliedPwm == 0) {
    lightStrobeActive = false;
    writeLights(false);
    digitalWrite(LIGHT_GREEN_PIN, HIGH);
    return;
  }
  digitalWrite(LIGHT_GREEN_PIN, LOW);
  if (!lightStrobeActive) {
    lightStrobeActive = true;
    lastLightToggleAt = now;
    writeLights(true);
    return;
  }
  if (now - lastLightToggleAt >= LIGHT_BLINK_HALF_PERIOD_MS) {
    lastLightToggleAt = now;
    writeLights(!redOutputOn);
  }
}

void writeMotor(int16_t pwm) {
  pwm = constrain(pwm, -int16_t(PWM_MAX), int16_t(PWM_MAX));
  if (MOTOR_DIRECTION_REVERSED) pwm = -pwm;
  if (pwm > 0) {
    ledcWrite(MOTOR_IN2_PIN, 0);
    ledcWrite(MOTOR_IN1_PIN, pwm);
  } else if (pwm < 0) {
    ledcWrite(MOTOR_IN1_PIN, 0);
    ledcWrite(MOTOR_IN2_PIN, -pwm);
  } else {
    ledcWrite(MOTOR_IN1_PIN, 0);
    ledcWrite(MOTOR_IN2_PIN, 0);
  }
}

void updateMotor() {
  const uint32_t now = millis();
  if (targetPwm == 0 && appliedPwm != 0) {
    appliedPwm = 0;
    lastRampAt = now;
    writeMotor(0);
    return;
  }
  if (appliedPwm == targetPwm) return;
  if (now - lastRampAt < RAMP_INTERVAL_MS) return;
  lastRampAt = now;
  if ((appliedPwm > 0 && targetPwm < 0) || (appliedPwm < 0 && targetPwm > 0)) {
    appliedPwm = 0;
  } else if (appliedPwm < targetPwm) {
    appliedPwm += RAMP_STEP;
    if (appliedPwm > targetPwm) appliedPwm = targetPwm;
  } else if (appliedPwm > targetPwm) {
    appliedPwm -= RAMP_STEP;
    if (appliedPwm < targetPwm) appliedPwm = targetPwm;
  }
  writeMotor(appliedPwm);
}

void updateServo() {
  if (appliedServoPosition == targetServoPosition) return;
  appliedServoPosition = targetServoPosition;
  writeServoAngle(appliedServoPosition);
}
