denishelenko/esp8266-motor-control/(commit log)

2026-09-23 Initial ESP8266 motor control system
2026-09-23 Use ESP-NOW for motor communication
2026-09-27 Update motor control UI and add motor test sketch
2026-09-28 Limit single ESP motor power to 20-60 percent
2026-10-05 Migrate motor control from MX1508 to L298N
2026-10-17 Add single ESP dual motor controller
2026-10-18 Add smooth servo control to single ESP interface
2026-10-19 Configure Wemos D1 Mini Pro pin mapping
2026-10-22 Add standalone motor servo LED firmware with motion strobe
2026-11-03 Add WiFi two-carriage ESP32 and NodeMCU controller
2026-11-03 Add interactive two-carriage web demo
2026-11-03 Format standalone two-carriage demo source
2026-11-03 Use SVG carriage and IPSC target visuals
2026-11-03 Model cable carriage with upper rollers
2026-11-03 Simplify carriage cards to status indicators
2026-11-03 Show WiFi signal and expand carriage track
2026-11-03 Refine two-carriage synchronization control
2026-11-05 Add two-carriage firmware wiring and mDNS site address
2026-11-05 Update one-carriage UI and 16m travel configuration
2026-11-06 Use red-only motion status LED
2026-11-06 Simplify repository for Arduino IDE
2026-11-06 Restructure Arduino sketches under 12GAN20-20
2026-11-06 Add timed calibration and motion programs
2026-11-06 Use motor.local for home Wi-Fi access
2026-11-06 Fix Arduino IDE home Wi-Fi include
2026-11-06 Set servo closed delay to 2500 milliseconds
2026-11-09 Set servo open hold to 2500 milliseconds
2026-11-09 Remove dedicated ENA GPIO from NodeMCU motor control
2026-11-10 Add dual ESP32-S3 L9110S carriage firmware
2026-11-10 Document ESP32-S3 L9110S wiring and power sequence
2026-11-11 Organize carriage firmware for Arduino IDE and PlatformIO
2026-11-11 Unify ESP32-S3 carriage pinout across firmware profiles
2026-11-11 Prepare ESP32-S3 controller for first USB upload
2026-11-11 Cache PlatformIO builds and export ESP32-S3 controller image
2026-11-12 Update ESP32-S3 firmware modules and PlatformIO dependencies
2026-11-13 Add timed physical calibration to dual-carriage firmware
